vincentchen18/polyphonic-synthesizer/BOM.csv

Item | Qty | Supplier | Cost/item | Total Cost | link
Custom PCB 300x90mm 2-layer (after $5 JLCONE coupon) | 5 | JLCPCB | $2.42 | $12.10 | https://jlcpcb.com
USB-C receptacle HRO TYPE-C-31-M-12 (C165948) | 5 | LCSC | $0.17 | $0.85 | https://www.lcsc.com/product-detail/C165948.html
SMAJ5.0CA TVS diode (C908809) | 20 | LCSC | $0.03 | $0.60 | https://www.lcsc.com/product-detail/C908809.html
SMD1206-050-16 500mA polyfuse (C46641014) | 10 | LCSC | $0.04 | $0.40 | https://www.lcsc.com/product-detail/C46641014.html
Raspberry Pi Pico RP2040 micro USB (incl. GST) | 1 | AliExpress | $3.16 | $3.16 | https://www.aliexpress.com/item/1005004565422217.html
Estimated total shipping | 1 |  |  | $11.19
