vincentchen18/polyphonic-synthesizer/3D Models/STLs/black keys.stl

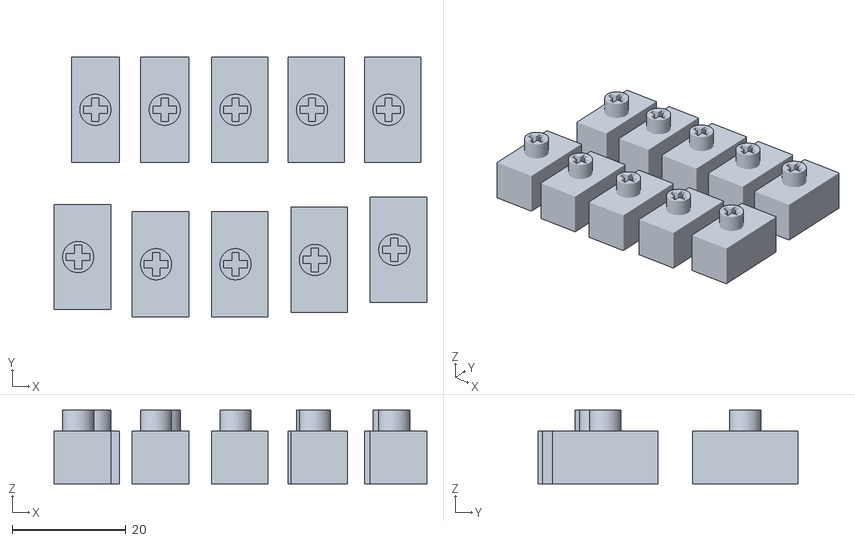
[picture p5: CAD file, 2026-10-22]
3D Models/STLs/black keys.stl
65.6 x 45.7 x 13.0
