vincentchen18/polyphonic-synthesizer/Kicad Files/CAD.step

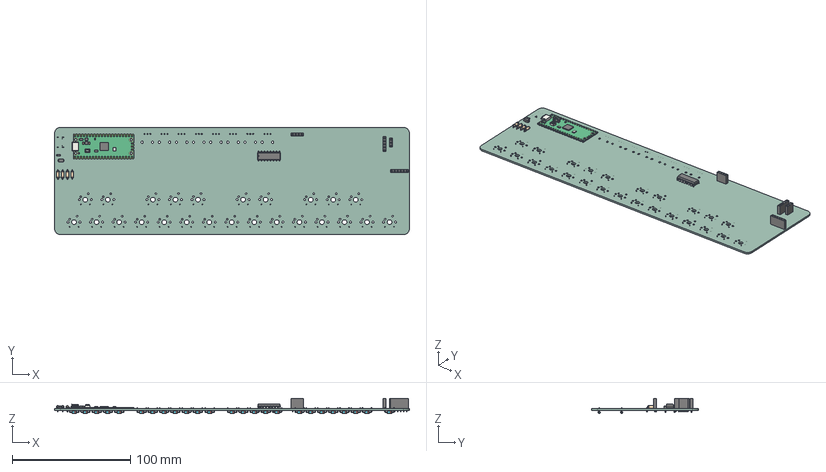
[picture p6: CAD file, 2026-10-21]
Kicad Files/CAD.step
300.1 x 90.5 x 12.7 mm
PinSocket_1x04_P2.54mm_Vertical
D_SMA
RaspberryPi_Pico_Module_KiCad
R_Axial_DIN0207_L63mm_D25mm_P762mm_Horizontal x 4
PinSocket_1x05_P2.54mm_Vertical
PinSocket_1x06_P2.54mm_Vertical
PinSocket_1x03_P2.54mm_Vertical
DIP-16_W7.62mm
Fuse_1206_3216Metric
D_DO-35_SOD27_P7.62mm_Horizontal x 25
Kicad Files-unsaved-export-bwKVS0_PCB
