vincentchen18/polyphonic-synthesizer/3D Models/STLs/white keys.stl

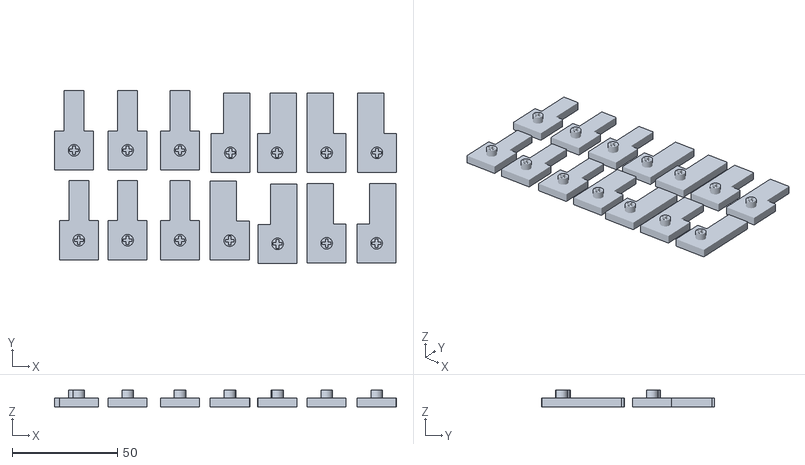
[picture p7: CAD file, 2026-10-22]
3D Models/STLs/white keys.stl
162.3 x 82.0 x 8.00
