vincentchen18/polyphonic-synthesizer/3D Models/STLs/3D Synthesizer.stl

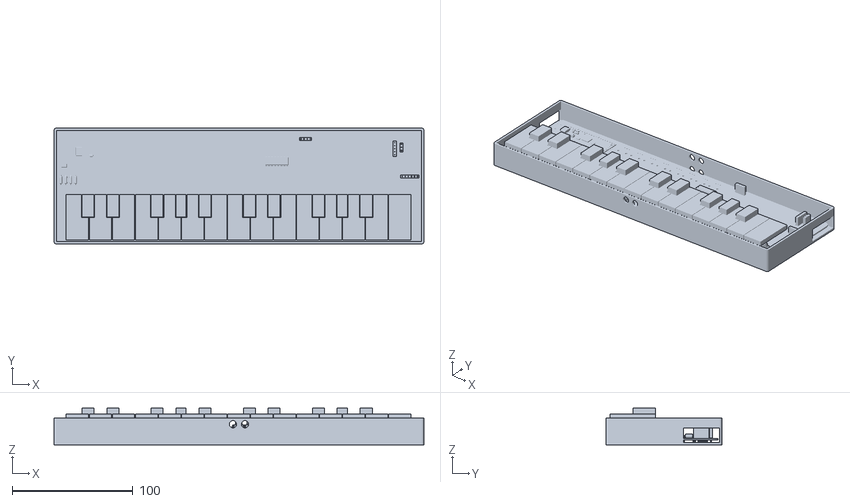
[picture p8: CAD file, 2026-10-22]
3D Models/STLs/3D Synthesizer.stl
306.0 x 96.0 x 30.3
