vincentchen18/polyphonic-synthesizer/3D Models/STLs/enclosure.stl

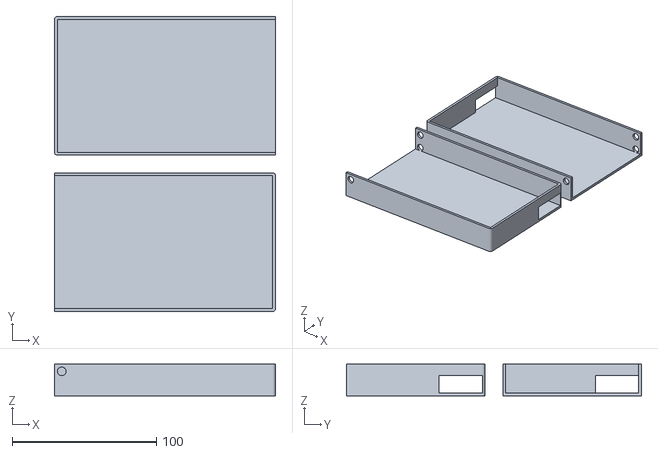
[picture p9: CAD file, 2026-10-22]
3D Models/STLs/enclosure.stl
153.0 x 204.2 x 22.0
