vincentchen18/polyphonic-synthesizer/JOURNAL.md

# Polyphonic Synthesizer – devlog

<!-- Generated by Half Life from project cmverqplh09zo01rc5bjvdwfp. Edits here are overwritten on the next sync. -->
<!-- Generated: 2026-10-25T10:46:08.773Z -->

> [!NOTE]
> This devlog is mirrored from [Half Life](https://halflife.hackclub.com) – [open the project](https://halflife.hackclub.com/projects/cmverqplh09zo01rc5bjvdwfp). Editing it here will not change the platform's copy, and the next sync overwrites this file.

> a 2 octave standalone musical instrument

| Week | Tier | Hours logged | Entries |
| --- | --- | --- | --- |
| Week 3 | Tier 1 | 14.86h | 11 |

## Contents

1. [2026-10-19 – Started buiding the schematics for my project, then realised in the middle that my resistors for 5.1k wont work because my resistors that i plan to buy with starbie don't contain 5.1k's so im parallel](#2026-10-19-started-buiding-the-schematics-for-my-project-the)
2. [2026-10-19 – finished the schematic, which needed an extra dac output thingy. i also assigned the footprints, which took a bit but weren't too annoying. finally, i also arranged most of the pcb, putting the diodes](#2026-10-19-finished-the-schematic-which-needed-an-extra-dac-)
3. [2026-10-20 – wired a lot of the pcb today, discovered the trhough hole tool (V) which proved to be extremely useful but it is still like trying to solve that pipes game. anyhow, i wired all the diodes to the butto](#2026-10-20-wired-a-lot-of-the-pcb-today-discovered-the-trhou)
4. [2026-10-21 – today i finished up the wiring (which is now extremely constrained and I don't think i can fit any more if it rerquired any) but at least its done. had some random spoke warnings but realised that the](#2026-10-21-today-i-finished-up-the-wiring-which-is-now-extre)
5. [2026-10-21 – i did a bunch of cad this session, mainly to make some keys for my synth, and it's been going quite swimmingly :). i needed to do some changes to make sure the holders were centered and to ensure that](#2026-10-21-i-did-a-bunch-of-cad-this-session-mainly-to-make-)
6. [2026-10-22 – finished making the dark keys during this session, now the synth finally looks like a piano!! :)))) also made an enclosure, debated different sitkcing methods for the top panel. Decided in the end to](#2026-10-22-finished-making-the-dark-keys-during-this-session)
7. [2026-10-23 – i wrote a readme in this session. yeah idk what else to say. specified the functionalities, but i still have firmware to make. im also planning the functionalities for the knobs, they will probably be](#2026-10-23-i-wrote-a-readme-in-this-session-yeah-idk-what-el)
8. [2026-10-23 – firmware writing](#2026-10-23-firmware-writing)
9. [2026-10-24 – more firmware coding this session, wired in teh main sound engine with 8 note polyphony (that means that maximum 8 notes can be played at a time and if a 9th is pressed i coded it to remove the quiete](#2026-10-24-more-firmware-coding-this-session-wired-in-teh-ma)
10. [2026-10-25 – finishing firmware, and i programmed in the last few knobs, especially the instrument one took a long time because i had to change the sound oscillations, but anyways i got it done. I also labelled th](#2026-10-25-finishing-firmware-and-i-programmed-in-the-last-f)
11. [2026-10-25 – searched some stuff for bom, realsied that my vin and gnd thingies were messed up in j4 so i swapped htem around. also updated readme for the bom.](#2026-10-25-searched-some-stuff-for-bom-realsied-that-my-vin-)

## Design

### 2026-10-19 – Started buiding the schematics for my project, then realised in the middle that my resistors for 5.1k wont work because my resistors that i plan to buy with starbie don't contain 5.1k's so im parallel

**1.22h**

Started buiding the schematics for my project, then realised in the middle that my resistors for 5.1k wont work because my resistors that i plan to buy with starbie don't contain 5.1k's so im paralleling 2 10ks. I also made an analog multiplexer to change the sounds of the notes, as well as make a coordinate based key system.









[Timelapse](https://lookout.hackclub.com/api/media/86279780-9619-4af9-bf46-4827b90f14d6/video.mp4)

### 2026-10-19 – finished the schematic, which needed an extra dac output thingy. i also assigned the footprints, which took a bit but weren't too annoying. finally, i also arranged most of the pcb, putting the diodes

**1.48h**

finished the schematic, which needed an extra dac output thingy. i also assigned the footprints, which took a bit but weren't too annoying. finally, i also arranged most of the pcb, putting the diodes under the keys, with a key arrangement that is expecting a CAD modelled piano keys. Also arranged most of the components but haven't wired yet, which may need to undergo revision.





[Timelapse](https://lookout.hackclub.com/api/media/4f58a627-521d-4c29-a1df-172c27aaedcd/video.mp4)

[Timelapse](https://lookout.hackclub.com/api/media/4bed8f16-b078-4778-9262-5c440bf5425b/video.mp4)

### 2026-10-20 – wired a lot of the pcb today, discovered the trhough hole tool (V) which proved to be extremely useful but it is still like trying to solve that pipes game. anyhow, i wired all the diodes to the butto

**1.97h**

wired a lot of the pcb today, discovered the trhough hole tool (V) which proved to be extremely useful but it is still like trying to solve that pipes game. anyhow, i wired all the diodes to the buttons, and also wired some of the pots to the PICO, as well as wiring the resistors and the cable plug.

[Timelapse](https://lookout.hackclub.com/api/media/e2d4e0e9-7c87-4826-8dbc-464f8d2edf98/video.mp4)

### 2026-10-21 – today i finished up the wiring (which is now extremely constrained and I don't think i can fit any more if it rerquired any) but at least its done. had some random spoke warnings but realised that the

**1.37h**

today i finished up the wiring (which is now extremely constrained and I don't think i can fit any more if it rerquired any) but at least its done. had some random spoke warnings but realised that they are harmless, and resolved all DRC issues. also ran the ground pour so most of GND parts are connected, but i did have to wire a few in isolated islands. Finally, i also drew some music notes and add some additional decor to my synthesizer.







[Timelapse](https://lookout.hackclub.com/api/media/29bba52b-92cc-4ef8-8360-05d6c1000184/video.mp4)

### 2026-10-21 – i did a bunch of cad this session, mainly to make some keys for my synth, and it's been going quite swimmingly :). i needed to do some changes to make sure the holders were centered and to ensure that

**1.67h**

i did a bunch of cad this session, mainly to make some keys for my synth, and it's been going quite swimmingly :). i needed to do some changes to make sure the holders were centered and to ensure that the keys would leave enough tolerance between each other and the cherry mx stem, and also spent a long time importing the cherry mx stem because they don't come exported from kicad. i managed to finish all the white keys. (still need the black keys). my project is really beginning to take shape.





[Timelapse](https://lookout.hackclub.com/api/media/59100c64-6a66-4dae-9e1f-75aeb5ebfcfd/video.mp4)

### 2026-10-22 – finished making the dark keys during this session, now the synth finally looks like a piano!! :)))) also made an enclosure, debated different sitkcing methods for the top panel. Decided in the end to

**2.22h**

finished making the dark keys during this session, now the synth finally looks like a piano!! :)))) also made an enclosure, debated different sitkcing methods for the top panel. Decided in the end to just use zip ties instead of bolts/screws or glue, since it's just easier. Then i modelled a top panel, and reallised that i would need to cut out too many holes so i gave up on it, as well as it would block the silkscreen art.



[Timelapse](https://lookout.hackclub.com/api/media/2e5c78d6-d899-4b49-a681-558d06ab0467/video.mp4)

### 2026-10-23 – i wrote a readme in this session. yeah idk what else to say. specified the functionalities, but i still have firmware to make. im also planning the functionalities for the knobs, they will probably be

**0.7h**

i wrote a readme in this session. yeah idk what else to say. specified the functionalities, but i still have firmware to make. im also planning the functionalities for the knobs, they will probably be volume and also adjust the instrument. oh yeah, i also removed the old cad file.

Screenshot from 2026-10-24 10-34-24



### 2026-10-23 – firmware writing

**1.38h**

firmware writing

i wrote the firmware in arduino to configure pins and keys, and also do some OLED drawing. also key indexing and detection should work.also, it does the oled drawing to clearly indicate the instrument, octave, and transposition.

[Timelapse](https://lookout.hackclub.com/api/media/4e67ab6f-e2bf-407e-9447-9b2055ff5192/video.mp4)

### 2026-10-24 – more firmware coding this session, wired in teh main sound engine with 8 note polyphony (that means that maximum 8 notes can be played at a time and if a 9th is pressed i coded it to remove the quiete

**0.55h**

more firmware coding this session, wired in teh main sound engine with 8 note polyphony (that means that maximum 8 notes can be played at a time and if a 9th is pressed i coded it to remove the quietest fading one), and alsoprogrammed in the functionality for the volume, attack, and release knob !! :))))

[Timelapse](https://lookout.hackclub.com/api/media/eb9f77f1-5353-437b-8fc5-51825b4a0cca/video.mp4)

### 2026-10-25 – finishing firmware, and i programmed in the last few knobs, especially the instrument one took a long time because i had to change the sound oscillations, but anyways i got it done. I also labelled th

**1.08h**

finishing firmware, and i programmed in the last few knobs, especially the instrument one took a long time because i had to change the sound oscillations, but anyways i got it done. I also labelled the knobs on silkscreen in the pcb editor. + some readme updates

[Timelapse](https://lookout.hackclub.com/api/media/58100256-204e-41f8-af99-a2ab4ca975ee/video.mp4)

### 2026-10-25 – searched some stuff for bom, realsied that my vin and gnd thingies were messed up in j4 so i swapped htem around. also updated readme for the bom.

**1.22h**

searched some stuff for bom, realsied that my vin and gnd thingies were messed up in j4 so i swapped htem around. also updated readme for the bom.

[Timelapse](https://lookout.hackclub.com/api/media/a7e9dccb-a69b-4977-9b88-0e6d0bd4ff9a/video.mp4)
