vincentchen18/polyphonic-synthesizer/Journal/img.png

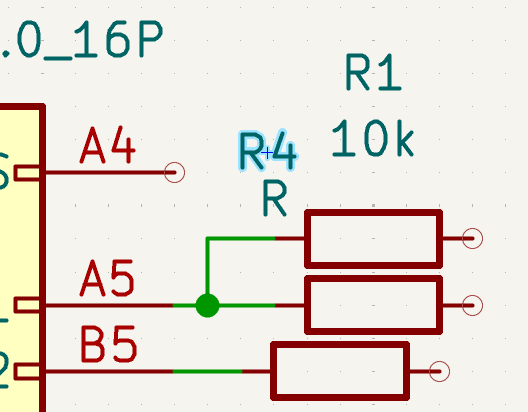
Journal/img.png
