vincentchen18/polyphonic-synthesizer/Journal/img_1.png

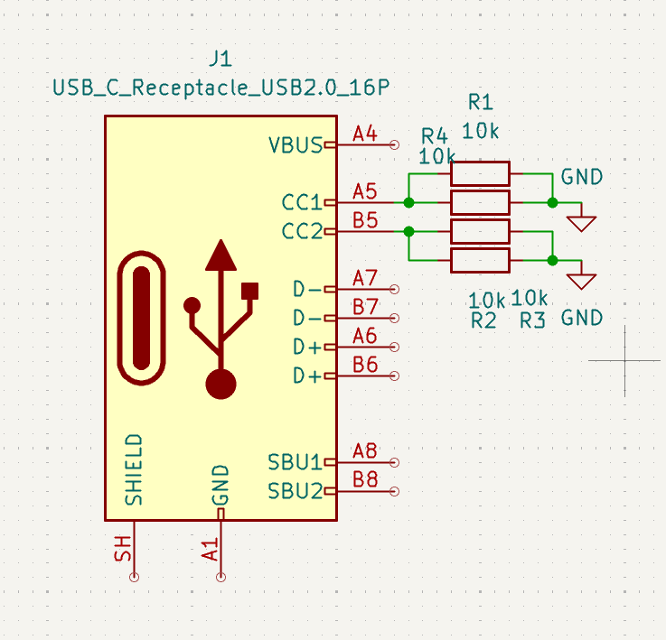
Journal/img_1.png
