vincentchen18/polyphonic-synthesizer/Journal/img_2.png

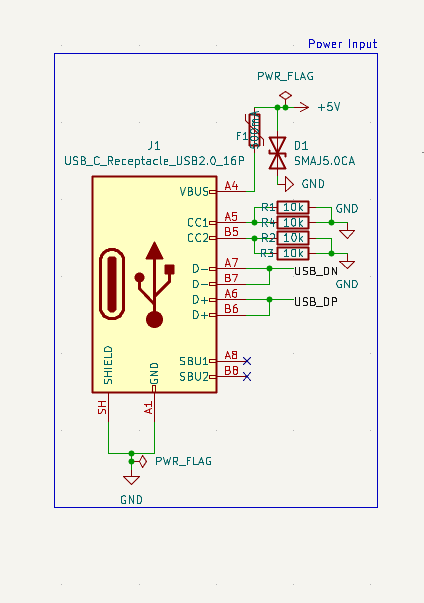
Journal/img_2.png
