vincentchen18/polyphonic-synthesizer/Journal/img_3.png

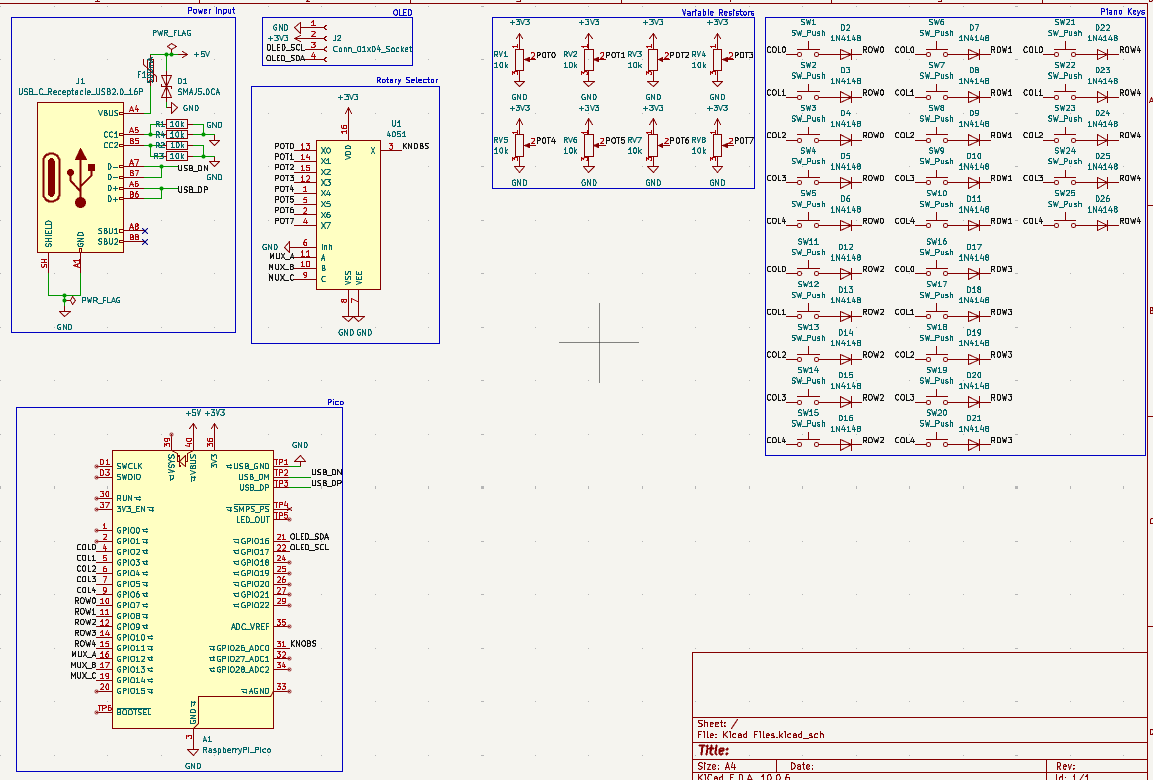
Journal/img_3.png
