vincentchen18/polyphonic-synthesizer/Journal/img_5.png

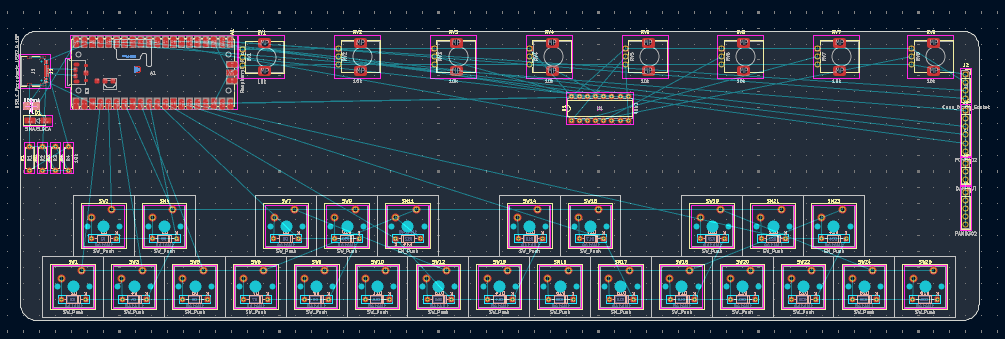
Journal/img_5.png
