vincentchen18/polyphonic-synthesizer/Journal/img_6.png

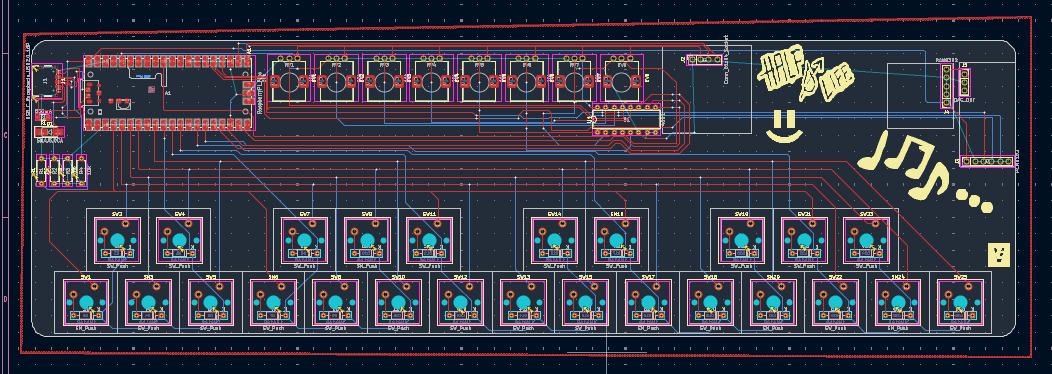
Journal/img_6.png
