vincentchen18/polyphonic-synthesizer/Journal/img_7.png

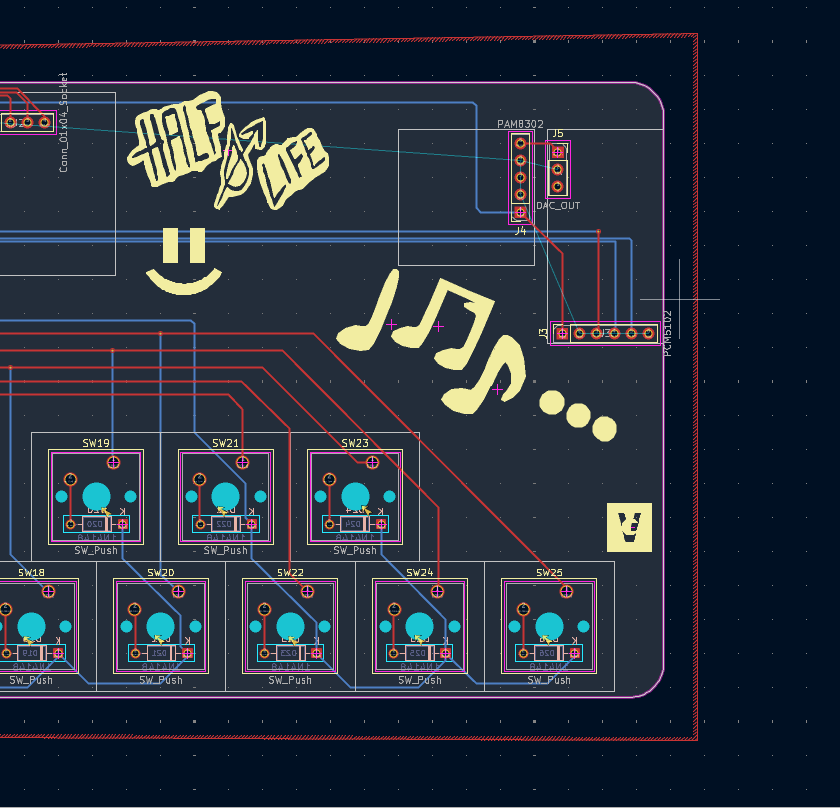
Journal/img_7.png
