vincentchen18/polyphonic-synthesizer/Journal/img_9.png

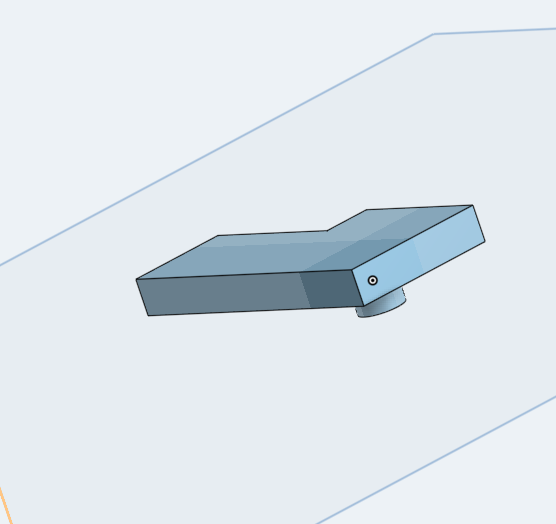
Journal/img_9.png
