vincentchen18/polyphonic-synthesizer/Journal/img_10.png

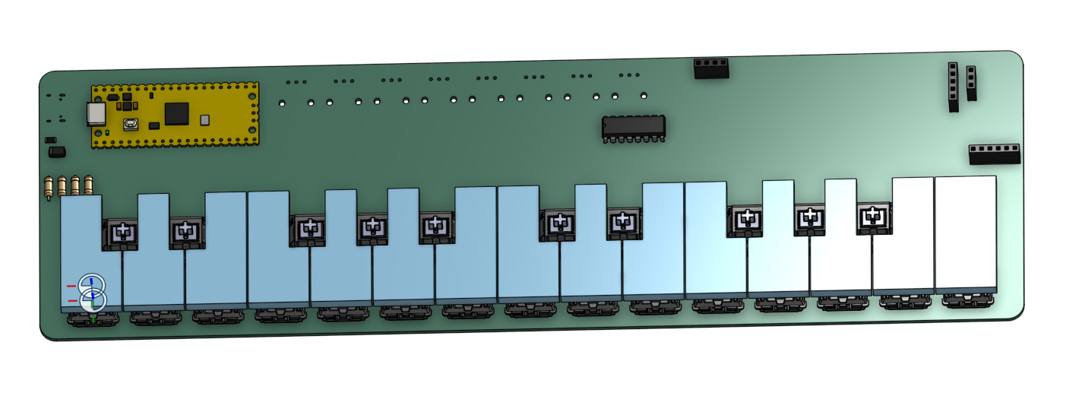
Journal/img_10.png
