vincentchen18/polyphonic-synthesizer/Kicad Files/Kicad Files.kicad_pcb

## KiCad design Kicad Files/Kicad Files.kicad_pcb (2026-10-25)

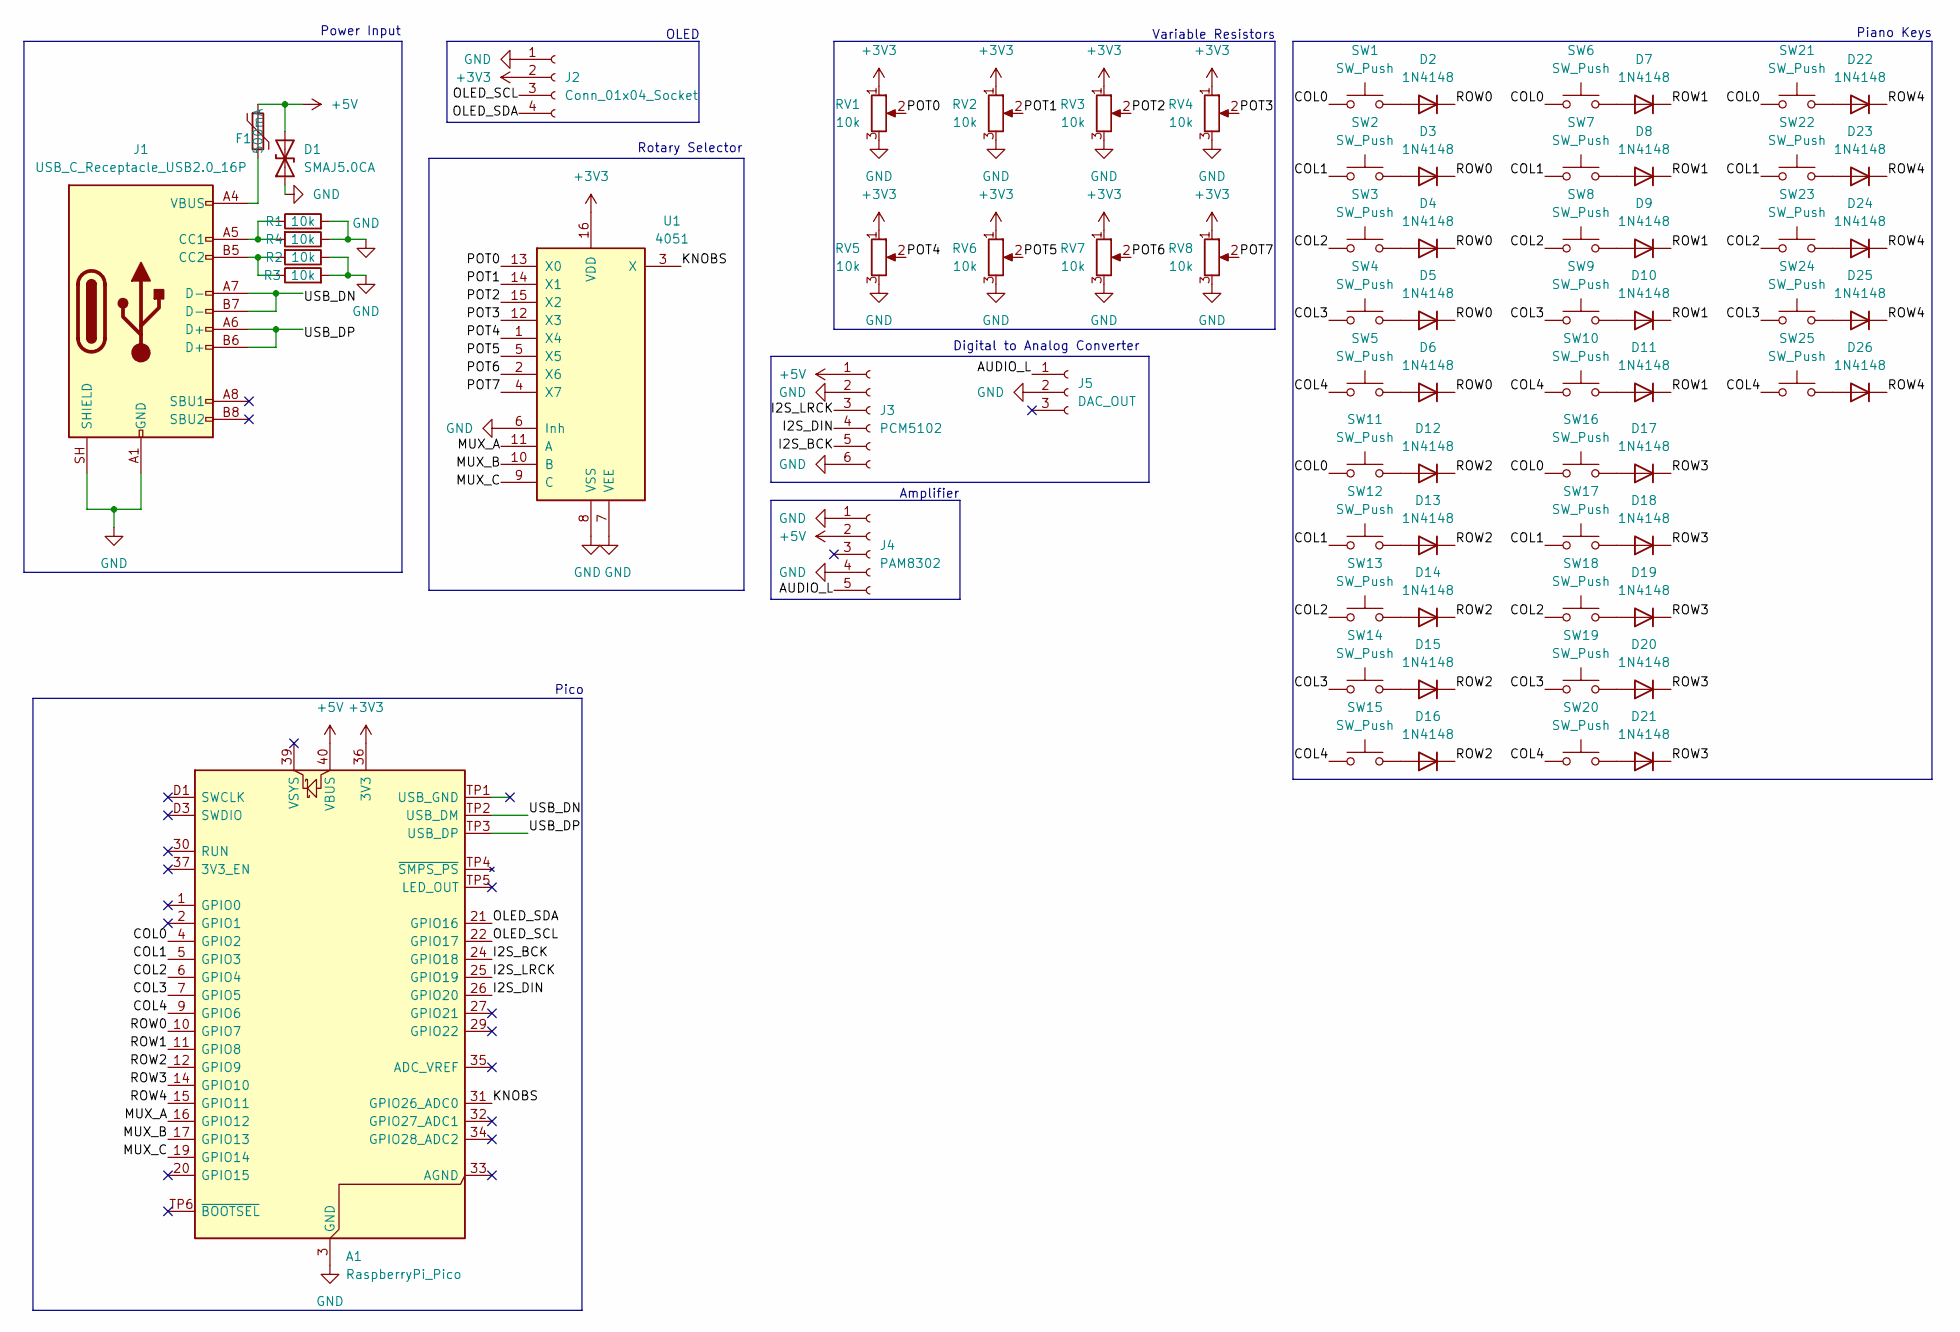
[picture p19: schematic Kicad Files.kicad_sch]

Parts:
A1: RaspberryPi_Pico; RaspberryPi_Pico_SMD
D1: SMAJ5.0CA; D_SMA_Handsoldering
D2, D3, D4, D5, D6, D7, D8, D9, D10, D11, D12, D13, D14, D15, D16, D17, D18, D19, D20, D21, D22, D23, D24, D25, D26: 1N4148; D_DO-35_SOD27_P7.62mm_Horizontal
F1: 500mA; Fuse_1206_3216Metric_Pad1.42x1.75mm_HandSolder
J1: USB_C_Receptacle_USB2.0_16P; USB_C_Receptacle_HRO_TYPE-C-31-M-12
J2: Conn_01x04_Socket; PinSocket_1x04_P2.54mm_Vertical
J3: PCM5102; PinSocket_1x06_P2.54mm_Vertical
J4: PAM8302; PinSocket_1x05_P2.54mm_Vertical
J5: DAC_OUT; PinSocket_1x03_P2.54mm_Vertical
R1, R2, R3, R4: 10k; R_Axial_DIN0207_L6.3mm_D2.5mm_P7.62mm_Horizontal
RV1, RV2, RV3, RV4, RV5, RV6, RV7, RV8: 10k; Potentiometer_Alps_RK09K_Single_Vertical
SW1, SW2, SW3, SW4, SW5, SW6, SW7, SW8, SW9, SW10, SW11, SW12, SW13, SW14, SW15, SW16, SW17, SW18, SW19, SW20, SW21, SW22, SW23, SW24, SW25: SW_Push; SW_Cherry_MX_1.00u_PCB
U1: 4051; DIP-16_W7.62mm

Connections:
+3V3: A1.36 (3V3), J2.2, RV1.1, RV2.1, RV3.1, RV4.1, RV5.1, RV6.1, RV7.1, RV8.1, U1.16 (VDD)
+5V: A1.40 (VBUS), D1.2 (A2), F1.1, J3.1, J4.2
/AUDIO_L: J4.5, J5.1
/COL0: A1.4 (GPIO2), SW1.1, SW6.1, SW11.1, SW16.1, SW21.1
/COL1: A1.5 (GPIO3), SW2.1, SW7.1, SW12.1, SW17.1, SW22.1
/COL2: A1.6 (GPIO4), SW3.1, SW8.1, SW13.1, SW18.1, SW23.1
/COL3: A1.7 (GPIO5), SW4.1, SW9.1, SW14.1, SW19.1, SW24.1
/COL4: A1.9 (GPIO6), SW5.1, SW10.1, SW15.1, SW20.1, SW25.1
/I2S_BCK: A1.24 (GPIO18), J3.5
/I2S_DIN: A1.26 (GPIO20), J3.4
/I2S_LRCK: A1.25 (GPIO19), J3.3
/KNOBS: A1.31 (GPIO26_ADC0), U1.3 (X)
/MUX_A: A1.16 (GPIO12), U1.11 (A)
/MUX_B: A1.17 (GPIO13), U1.10 (B)
/MUX_C: A1.19 (GPIO14), U1.9 (C)
/OLED_SCL: A1.22 (GPIO17), J2.3
/OLED_SDA: A1.21 (GPIO16), J2.4
/POT0: RV1.2, U1.13 (X0)
/POT1: RV2.2, U1.14 (X1)
/POT2: RV3.2, U1.15 (X2)
/POT3: RV4.2, U1.12 (X3)
/POT4: RV5.2, U1.1 (X4)
/POT5: RV6.2, U1.5 (X5)
/POT6: RV7.2, U1.2 (X6)
/POT7: RV8.2, U1.4 (X7)
/ROW0: A1.10 (GPIO7), D2.1 (K), D3.1 (K), D4.1 (K), D5.1 (K), D6.1 (K)
/ROW1: A1.11 (GPIO8), D7.1 (K), D8.1 (K), D9.1 (K), D10.1 (K), D11.1 (K)
/ROW2: A1.12 (GPIO9), D12.1 (K), D13.1 (K), D14.1 (K), D15.1 (K), D16.1 (K)
/ROW3: A1.14 (GPIO10), D17.1 (K), D18.1 (K), D19.1 (K), D20.1 (K), D21.1 (K)
/ROW4: A1.15 (GPIO11), D22.1 (K), D23.1 (K), D24.1 (K), D25.1 (K), D26.1 (K)
/USB_DN: A1.TP2 (USB_DM), J1.A7 (D-), J1.B7 (D-)
/USB_DP: A1.TP3 (USB_DP), J1.A6 (D+), J1.B6 (D+)
GND: A1.3 (GND), A1.8 (GND), A1.13 (GND), A1.18 (GND), A1.23 (GND), A1.28 (GND), A1.38 (GND), A1.D2 (GND), D1.1 (A1), J1.A1 (GND), J1.A12 (GND), J1.B1 (GND), J1.B12 (GND), J1.SH (SHIELD), J2.1, J3.2, J3.6, J4.1, J4.4, J5.2, R1.2, R2.1, R3.2, R4.1, RV1.3, RV2.3, RV3.3, RV4.3, RV5.3, RV6.3, RV7.3, RV8.3, U1.6 (Inh), U1.7 (VEE), U1.8 (VSS)
unnamed: D2.2 (A), SW1.2
unnamed: D3.2 (A), SW2.2
unnamed: D4.2 (A), SW3.2
unnamed: D5.2 (A), SW4.2
unnamed: D6.2 (A), SW5.2
unnamed: D7.2 (A), SW6.2
unnamed: D8.2 (A), SW7.2
unnamed: D9.2 (A), SW8.2
unnamed: D10.2 (A), SW9.2
unnamed: D11.2 (A), SW10.2
unnamed: D12.2 (A), SW11.2
unnamed: D13.2 (A), SW12.2
unnamed: D14.2 (A), SW13.2
unnamed: D15.2 (A), SW14.2
unnamed: D16.2 (A), SW15.2
unnamed: D17.2 (A), SW16.2
unnamed: D18.2 (A), SW17.2
unnamed: D19.2 (A), SW18.2
unnamed: D20.2 (A), SW19.2
unnamed: D21.2 (A), SW20.2
unnamed: D22.2 (A), SW21.2
unnamed: D23.2 (A), SW22.2
unnamed: D24.2 (A), SW23.2
unnamed: D25.2 (A), SW24.2
unnamed: D26.2 (A), SW25.2
unnamed: F1.2, J1.A4 (VBUS), J1.A9 (VBUS), J1.B4 (VBUS), J1.B9 (VBUS)
unnamed: J1.A5 (CC1), R1.1, R4.2
unnamed: J1.B5 (CC2), R2.2, R3.1

Notes on the sheet:
Piano Keys
Amplifier
Digital to Analog Converter
Rotary Selector
Pico
Variable Resistors
OLED
Power Input

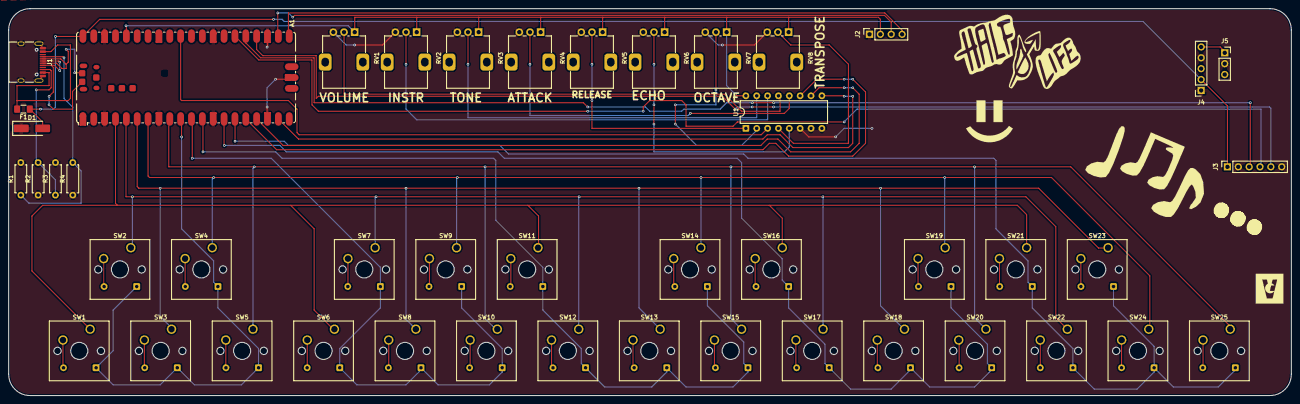
[picture p20: board Kicad Files.kicad_pcb from above]

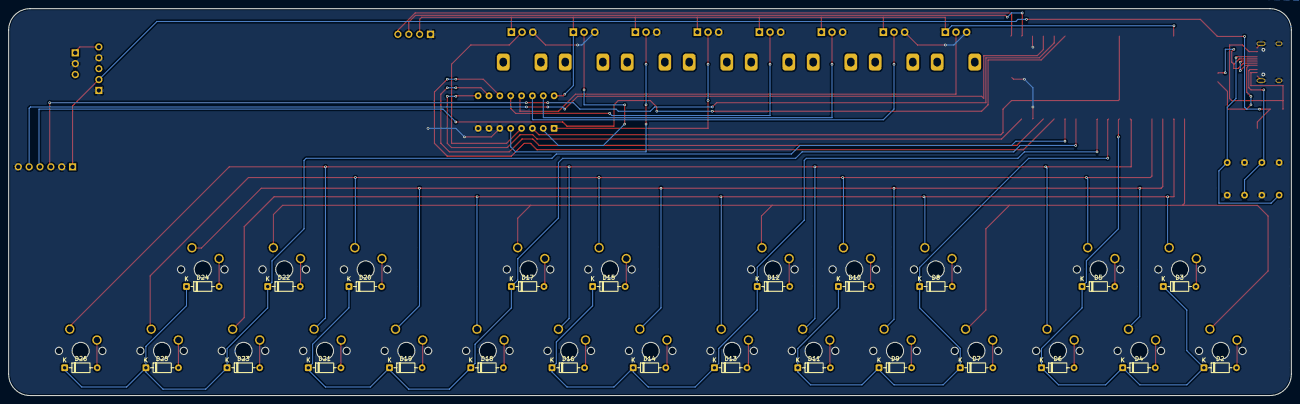
[picture p21: board Kicad Files.kicad_pcb from below]

Board: 2 copper layers, 300.1 x 90.5 mm, 71 parts (25 on the bottom side), 61 nets.
