vincentchen18/polyphonic-synthesizer/(commit log)

2026-10-19 some schematic parts :D
    [Kicad Files.kicad_pcb, Kicad Files.kicad_sch]
2026-10-19 finish schematics + footprints. arranged pcb in editor, but not wired
    [Kicad Files.kicad_pcb, Kicad Files.kicad_sch]
2026-10-19 Sync Polyphonic Synthesizer from Half Life
    [BOM.csv]
2026-10-20 wire more of the pcb
    [Kicad Files.kicad_pcb]
2026-10-21 add decor and finish wire
    [CAD.step, Kicad Files.kicad_pcb]
2026-10-21 make some keys
    [partially completed keyboard.step]
2026-10-22 finish up 3d models git add .! :D
    [3D Synthesizer.stl, black keys.stl, enclosure.stl, white keys.stl]
2026-10-23 mkaeing readme
    [partially completed keyboard.step]
2026-10-25 readme pushing
    [Kicad Files-B_Cu.gbr, Kicad Files-B_Mask.gbr, Kicad Files-B_Paste.gbr, Kicad Files-B_Silkscreen.gbr, Kicad Files-Edge_Cuts.gbr, Kicad Files-F_Cu.gbr, Kicad Files-F_Mask.gbr, Kicad Files-F_Paste.gbr]
2026-10-25 newbom for grant/self funded stuff
    [BOM.csv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]
2026-10-25 final bom fix
    [BOM.csv]
